wattnotions/PrettySmallRobot/README.md

[Watch the video here](https://www.youtube.com/watch?v=d6PTFtglKmE&feature=youtu.be)
