wattnotions/PrettySmallRobot/Kicad/adafruit_products_QT_Py_rev_C_sch.png

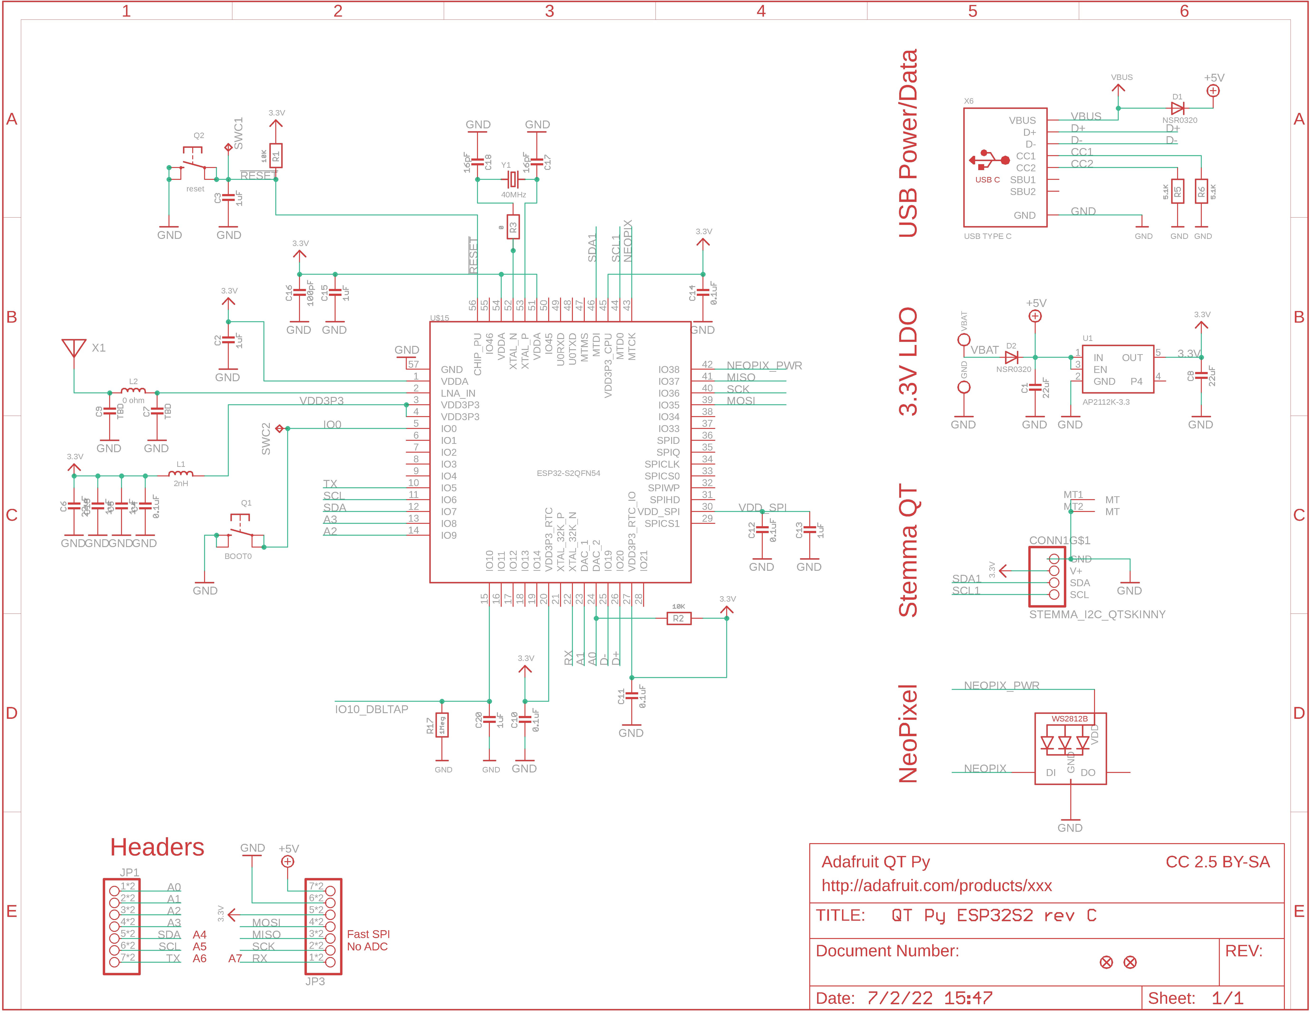
Kicad/adafruit_products_QT_Py_rev_C_sch.png
