wattnotions/PrettySmallRobot/Kicad/pi_matching_calcs.PNG

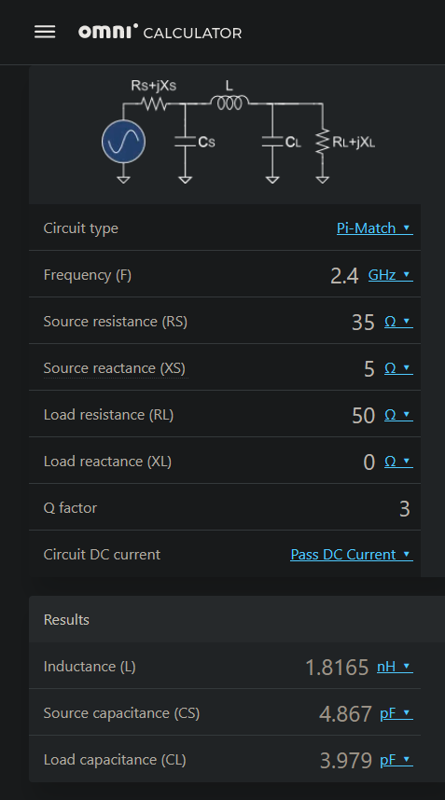
Kicad/pi_matching_calcs.PNG
