wattnotions/PrettySmallRobot/Kicad/wifi_car.PNG

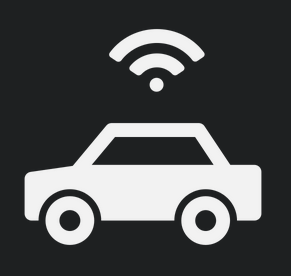
Kicad/wifi_car.PNG
