wattnotions/PrettySmallRobot/Kicad/PrettySmallRobot.step

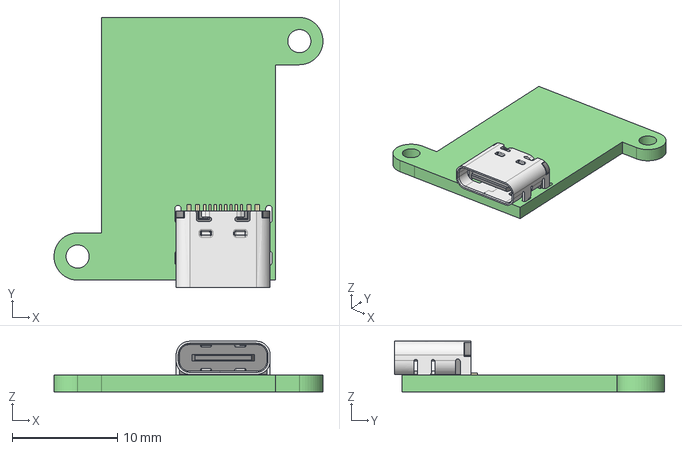
[picture p4: CAD file, 2023-01-18]
Kicad/PrettySmallRobot.step
25.6 x 25.7 x 4.82 mm
PrettySmallRobot PCB
