wattnotions/PrettySmallRobot/Step_files/Motor_Wheel.stl

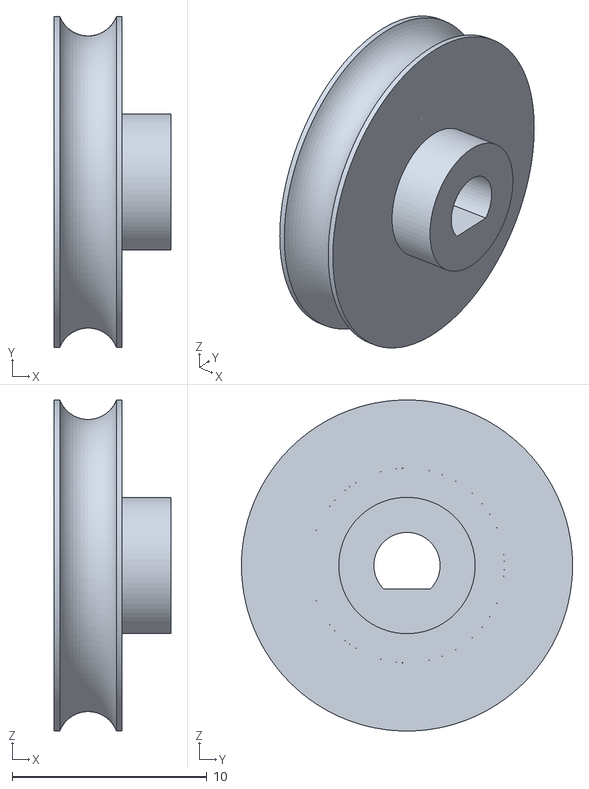
[picture p5: CAD file, 2023-03-26]
Step_files/Motor_Wheel.stl
6.00 x 17.0 x 17.0
