wattnotions/PrettySmallRobot/Step_files/Bearing_Wheel.stl

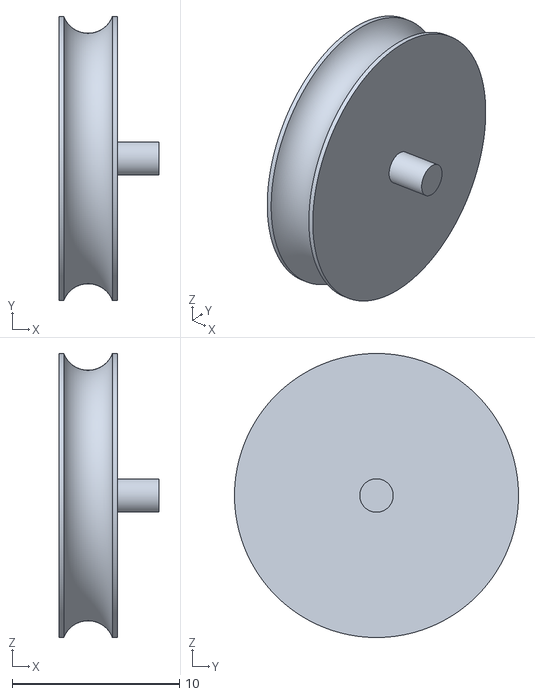
[picture p6: CAD file, 2023-03-26]
Step_files/Bearing_Wheel.stl
6.00 x 17.0 x 17.0
