wattnotions/PrettySmallRobot/Step_files/Chassis.stl

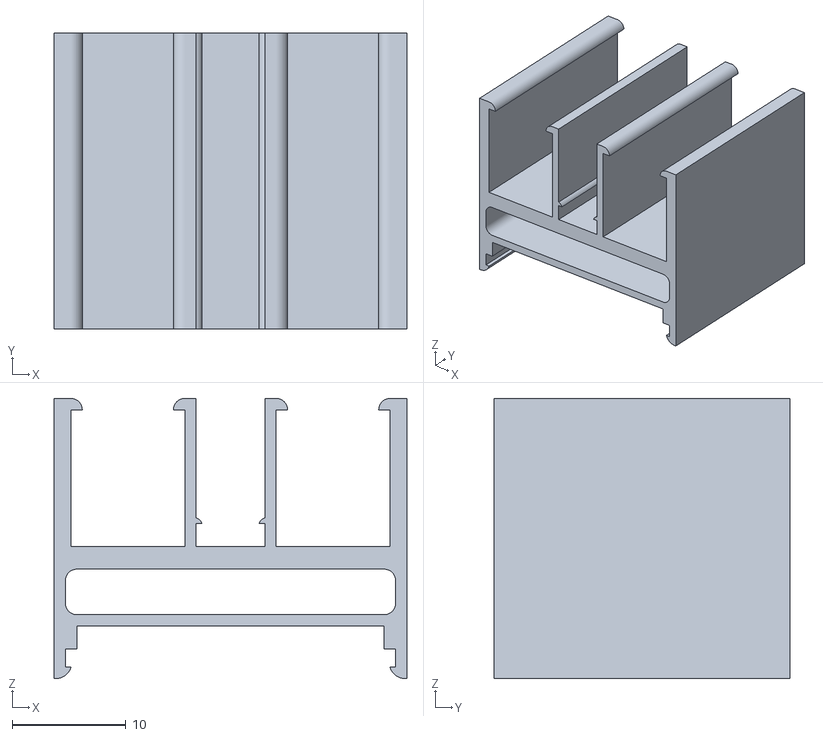
[picture p7: CAD file, 2023-01-28]
Step_files/Chassis.stl
31.0 x 26.0 x 24.6
