wattnotions/PrettySmallRobot/Kicad/PrettySmallRobot.pdf

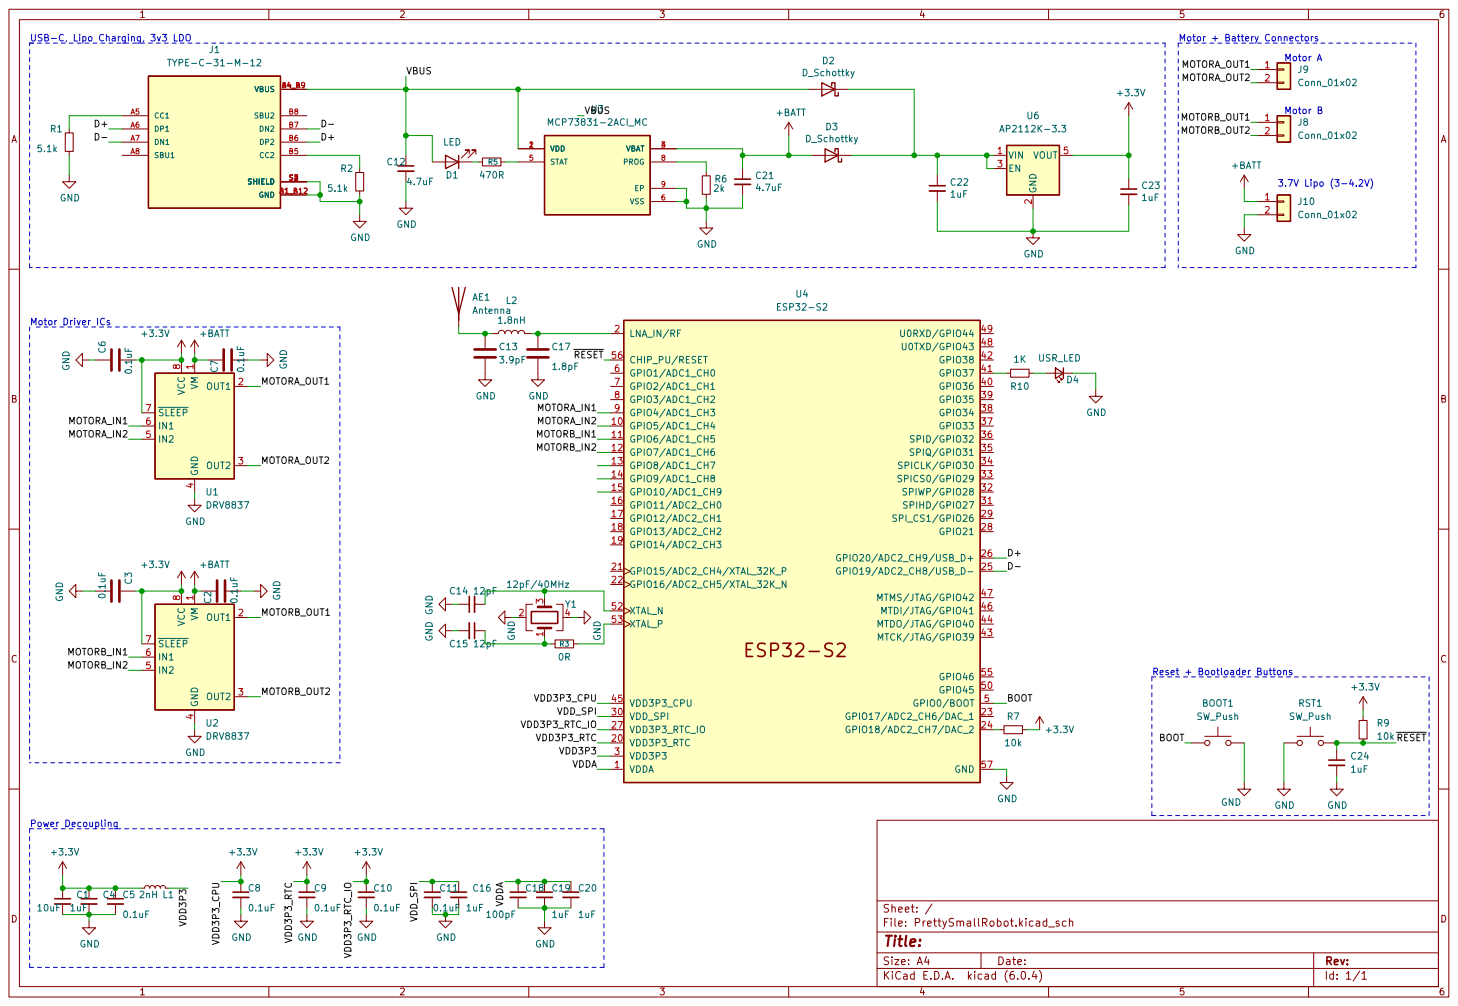
[picture p8: page 1]

2 EN 3 VOUT 5 U6 AP2112K-3.3 GND GND

File: PrettySmallRobot.kicad_sch Sheet: / GND GND
