wattnotions/PrettySmallRobot/Kicad/SCH.pdf

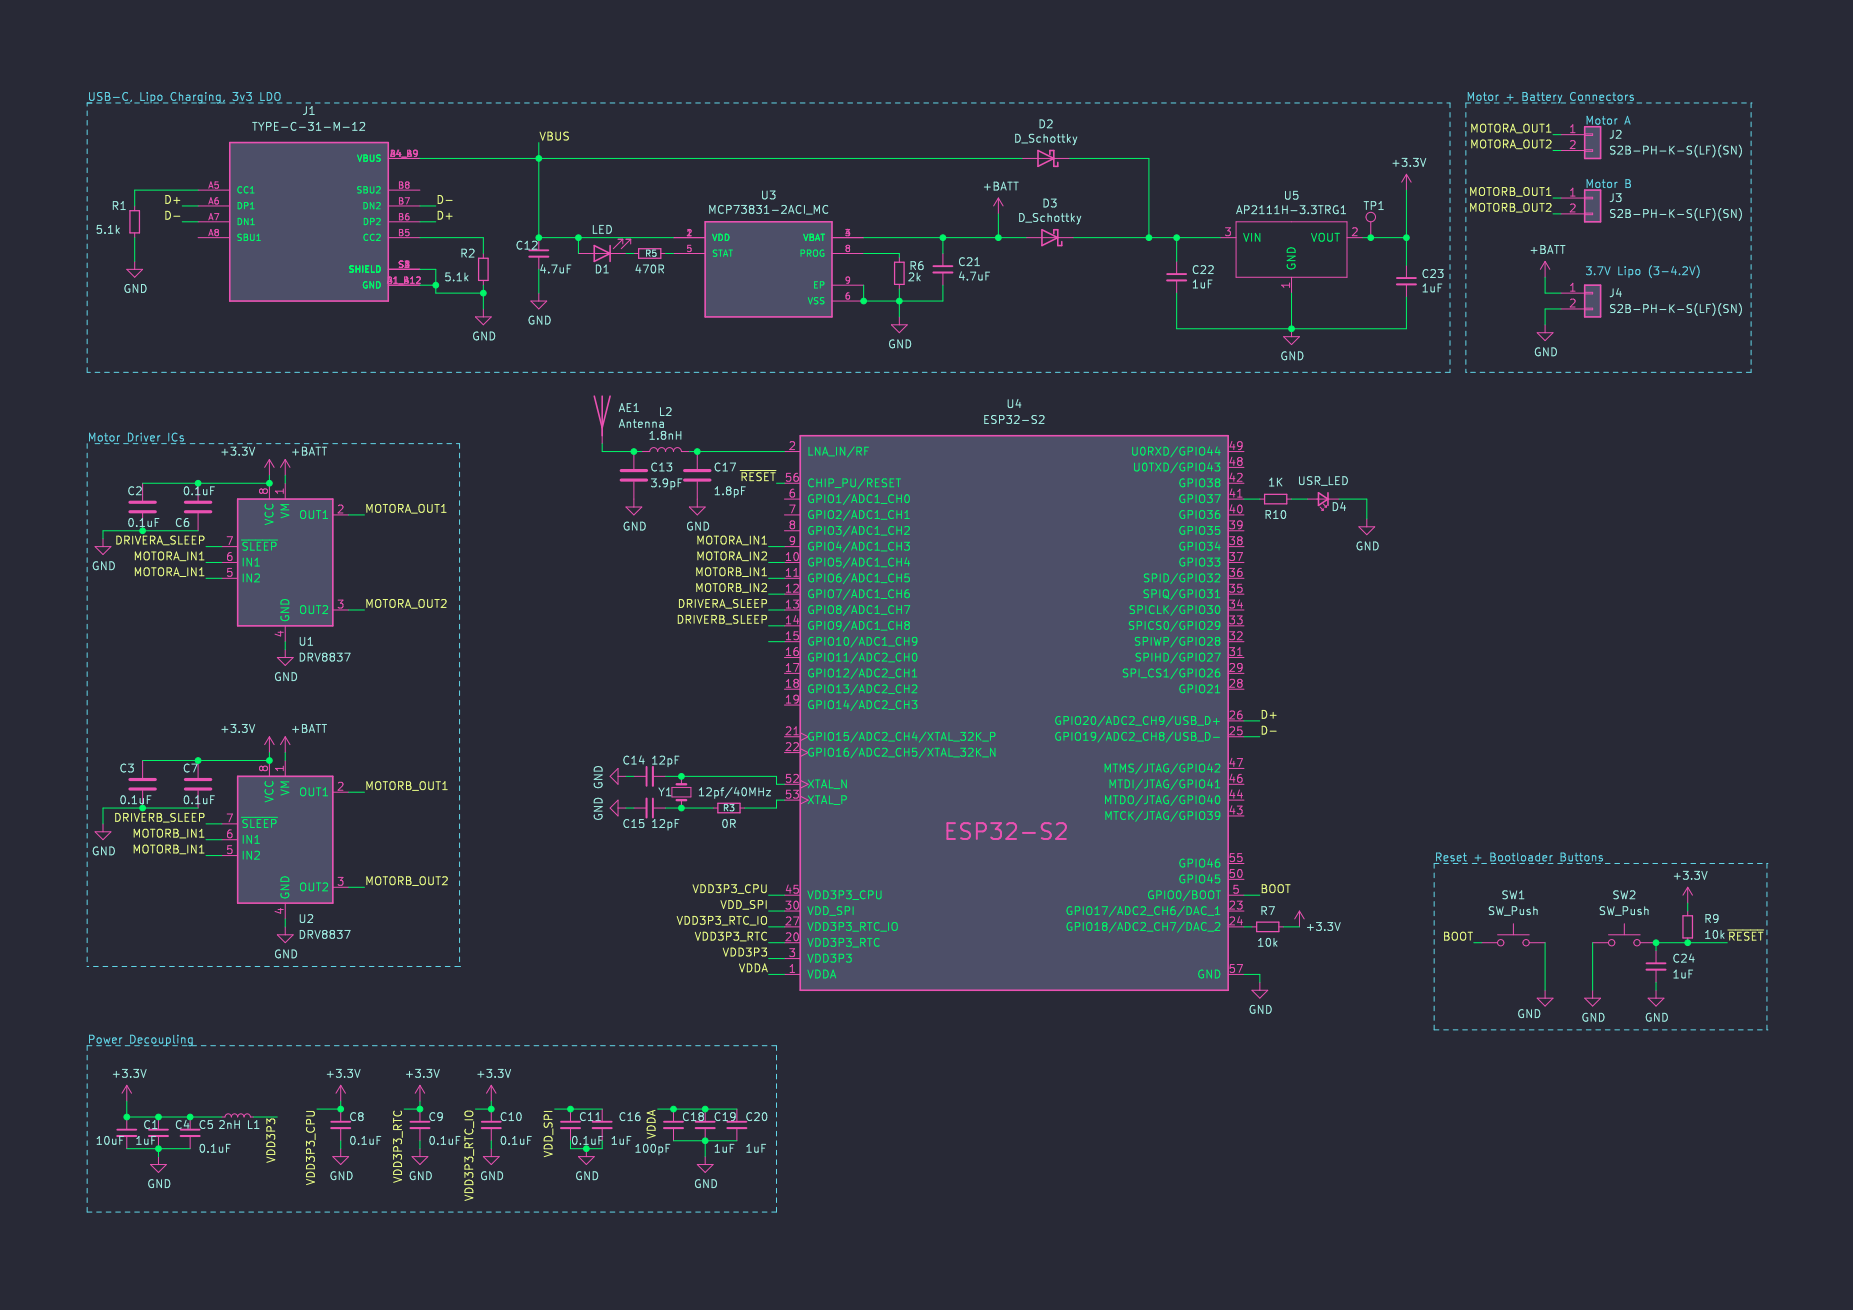
[picture p9: page 1]
