wattnotions/PrettySmallRobot/Kicad/PrettySmallRobot.kicad_pcb

## KiCad design Kicad/PrettySmallRobot.kicad_pcb (2023-03-03)

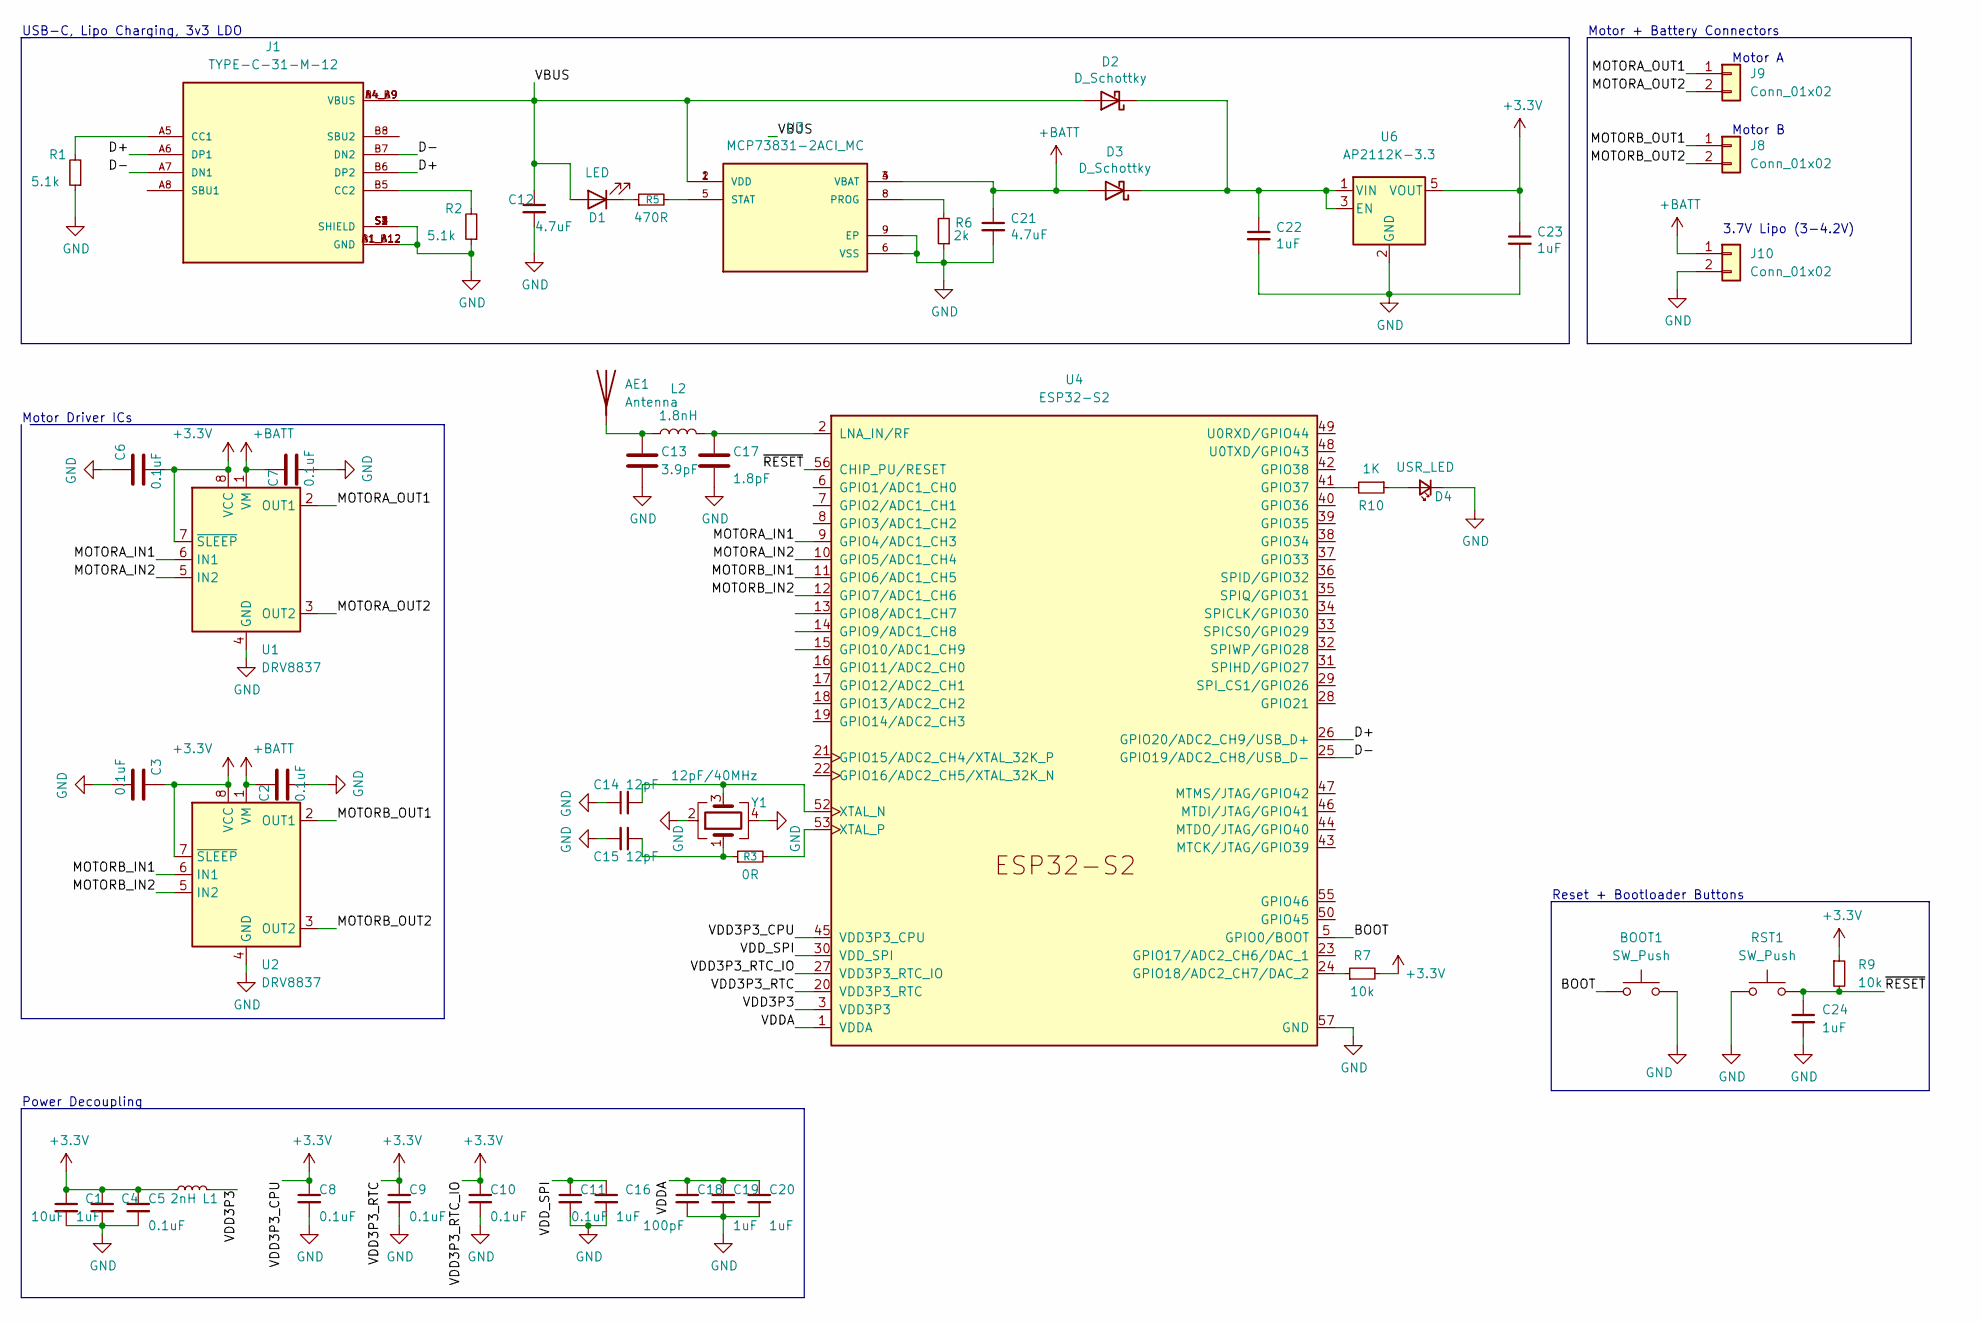
[picture p10: schematic PrettySmallRobot.kicad_sch]

Parts:
AE1: Antenna; C_1206_3216Metric; LCSC C293767
BOOT1: SW_Push; SW_SPST_B3U-1000P; LCSC C231329
C1: 10uF; C_0603_1608Metric
C2, C3, C5, C6, C7, C8, C9, C10, C11: 0.1uF; C_0402_1005Metric
C4, C16, C19, C20, C22, C23, C24: 1uF; C_0402_1005Metric
C12, C21: 4.7uF; C_0402_1005Metric
C13: 3.9pF; C_0402_1005Metric; LCSC C313081
C14, C15: 12pF; C_0402_1005Metric; LCSC C1547
C17: 1.8pF; C_0402_1005Metric; LCSC C140677
C18: 100pF; C_0402_1005Metric
D1: LED; LED_0402_1005Metric
D2, D3: D_Schottky; D_SOD-323; LCSC C146335
D4: USR_LED; LED_0402_1005Metric
J1: TYPE-C-31-M-12; HRO_TYPE-C-31-M-12; PARTREV 2020.12.08; LCSC C165948
J8, J9, J10: Conn_01x02; JST_PH_S2B-PH-K_1x02_P2.00mm_Horizontal
L1: 2nH; L_0402_1005Metric
L2: 1.8nH; L_0402_1005Metric; LCSC C87530
R1, R2: 5.1k; R_0402_1005Metric
R3: 0R; R_0402_1005Metric
R5: 470R; R_0402_1005Metric
R6: 2k; R_0402_1005Metric
R7, R9: 10k; R_0402_1005Metric
R10: 1K; R_0402_1005Metric
RST1: SW_Push; SW_SPST_B3U-1000P; LCSC TSA363G25-250B
U1, U2: DRV8837; WSON-8-1EP_2x2mm_P0.5mm_EP0.9x1.6mm; LCSC C191000
U3: MCP73831-2ACI_MC; SON50P200X300X100-9N; PARTREV G; LCSC C150772
U4: ESP32-S2; QFN-56-1EP_7x7mm_P0.4mm_EP5.6x5.6mm; LCSC C529594
U6: AP2112K-3.3; SOT-23-5; LCSC C3021085
Y1: 12pF/40MHz; Crystal_SMD_3225-4Pin_3.2x2.5mm; LCSC C252255

Connections:
+3V3: C1.1, C3.1, C4.1, C5.1, C6.1, C8.1, C9.1, C10.1, C23.1, L1.1, R7.2, R9.1, U1.7 (~SLEEP), U1.8 (VCC), U2.7 (~SLEEP), U2.8 (VCC), U4.20 (VDD3P3_RTC), U4.27 (VDD3P3_RTC_IO), U4.45 (VDD3P3_CPU), U6.5 (VOUT)
+BATT: C2.1, C7.1, C21.1, D3.2 (A), J10.1, U1.1 (VM), U2.1 (VM), U3.3 (VBAT), U3.4 (VBAT)
/BOOT: BOOT1.1, U4.5 (GPIO0/BOOT)
/D+: J1.A6 (DP1), J1.B6 (DP2), U4.26 (GPIO20/ADC2_CH9/USB_D+)
/D-: J1.A7 (DN1), J1.B7 (DN2), U4.25 (GPIO19/ADC2_CH8/USB_D-)
/MOTORA_IN1: U1.6 (IN1), U4.9 (GPIO4/ADC1_CH3)
/MOTORA_IN2: U1.5 (IN2), U4.10 (GPIO5/ADC1_CH4)
/MOTORA_OUT1: J9.1, U1.2 (OUT1)
/MOTORA_OUT2: J9.2, U1.3 (OUT2)
/MOTORB_IN1: U2.6 (IN1), U4.11 (GPIO6/ADC1_CH5)
/MOTORB_IN2: U2.5 (IN2), U4.12 (GPIO7/ADC1_CH6)
/MOTORB_OUT1: J8.1, U2.2 (OUT1)
/MOTORB_OUT2: J8.2, U2.3 (OUT2)
/VBUS: C12.1, D1.2 (A), D2.2 (A), J1.A4_B9 (VBUS), J1.B4_A9 (VBUS), U3.1 (VDD), U3.2 (VDD)
/VDD3P3: L1.2, U4.3 (VDD3P3), U4.4 (VDD3P3)
/VDDA: C18.1, C19.1, C20.1, U4.1 (VDDA), U4.51 (VDDA), U4.54 (VDDA)
/VDD_SPI: C11.1, C16.1, U4.30 (VDD_SPI)
/~RESET: C24.1, R9.2, RST1.2, U4.56 (CHIP_PU/RESET)
GND: BOOT1.2, C1.2, C2.2, C3.2, C4.2, C5.2, C6.2, C7.2, C8.2, C9.2, C10.2, C11.2, C12.2, C13.2, C14.1, C15.2, C16.2, C17.2, C18.2, C19.2, C20.2, C21.2, C22.2, C23.2, C24.2, D4.1 (K), J1.A1_B12 (GND), J1.B1_A12 (GND), J1.S1 (SHIELD), J1.S2 (SHIELD), J1.S3 (SHIELD), J1.S4 (SHIELD), J10.2, R1.1, R2.1, R6.1, RST1.1, U1.4 (GND), U1.9 (GND), U2.4 (GND), U2.9 (GND), U3.6 (VSS), U3.9 (EP), U4.57 (GND), U6.2 (GND), Y1.2, Y1.4
unnamed: AE1.1 (A), C13.1, L2.1
unnamed: C14.2, U4.52 (XTAL_N), Y1.3
unnamed: C15.1, R3.1, Y1.1
unnamed: C17.1, L2.2, U4.2 (LNA_IN/RF)
unnamed: C22.1, D2.1 (K), D3.1 (K), U6.1 (VIN), U6.3 (EN)
unnamed: D1.1 (K), R5.1
unnamed: D4.2 (A), R10.1
unnamed: J1.A5 (CC1), R1.2
unnamed: J1.B5 (CC2), R2.2
unnamed: R3.2, U4.53 (XTAL_P)
unnamed: R5.2, U3.5 (STAT)
unnamed: R6.2, U3.8 (PROG)
unnamed: R7.1, U4.24 (GPIO18/ADC2_CH7/DAC_2)
unnamed: R10.2, U4.41 (GPIO37)

Notes on the sheet:
Reset + Bootloader Buttons
USB-C, Lipo Charging, 3v3 LDO
Motor A
Power Decoupling
Motor B
3.7V Lipo (3-4.2V)
Motor Driver ICs
Motor + Battery Connectors

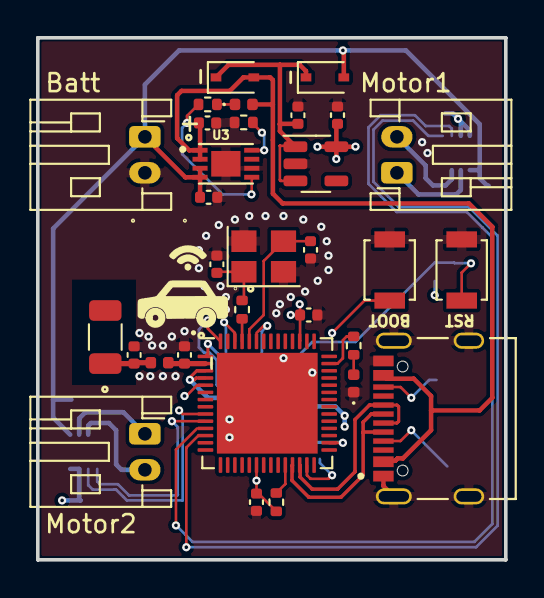
[picture p11: board PrettySmallRobot.kicad_pcb from above]

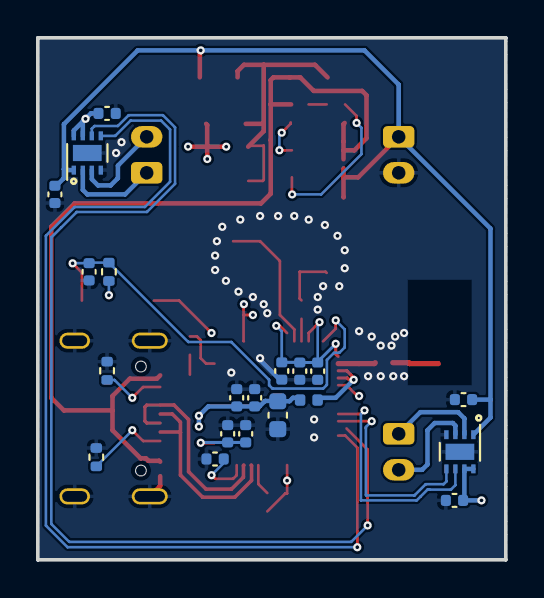
[picture p12: board PrettySmallRobot.kicad_pcb from below]

Board: 4 copper layers, 26.0 x 29.0 mm, 51 parts (20 on the bottom side), 33 nets.
