wattnotions/PrettySmallRobot/(threads)

Thread 1 (2023-05-31):

Motor type?

spezifisch, 2023-05-31:
Hello, what a nice project!

You write in [your post](https://www.wattnotions.com/pretty-small-robot-first-working-prototype/) that you consider a lower ratio gearbox for the N20 motors.
Which gearbox are you currently using? And are you using the 6V version of this motor like [here](https://www.adafruit.com/product/4640) (but without encoder)?

Regards,
spezifisch

Thread 2 (2023-07-14):

Production (JLCPCB)

aguileraGit, 2023-07-14:
Anything special for production? Specifically around the impedance on the antenna trace?

Does the KiCad file include the design rules for JLC PCB?
