wattnotions/PrettySmallRobot/(commit log)

2023-01-12 1ST COMMIT
    [Body1.stl, Body1_v2.stl, Body1_v3.stl, CHASSIS_V2.stl, PrettySmallRobot.kicad_pcb, PrettySmallRobot.kicad_sch, Wheel.stl, bearing_wheel.stl]
2023-01-12 added antenna match circuit
    [PrettySmallRobot.kicad_sch]
2023-01-12 schematic progressed
    [PrettySmallRobot.kicad_sch]
2023-01-12 progressed schematic
    [PrettySmallRobot.kicad_sch]
2023-01-14 usb c nets done, started on esp32 nets
    [PrettySmallRobot.kicad_sch]
2023-01-14 progressed esp32 schem nets
    [PrettySmallRobot.kicad_sch]
2023-01-14 cleaned up schematic - added boxes around sections etc
    [PrettySmallRobot.kicad_sch]
2023-01-14 worked on motor driver signals
    [PrettySmallRobot.kicad_sch]
2023-01-14 added testpoint on 3v3
    [PrettySmallRobot.kicad_sch]
2023-01-15 removed pullups on driver enable signals
    [PrettySmallRobot.kicad_sch]
2023-01-15 added pi matching network vals + lcsc numbers
    [PrettySmallRobot.kicad_sch]
2023-01-15 matched 90% of parts with footprints
    [PrettySmallRobot.kicad_sch]
2023-01-15 preliminary floorplanning done
    [PrettySmallRobot.kicad_pcb, PrettySmallRobot.kicad_sch]
2023-01-17 replaced 3.3v ldo with ap2112k
    [PrettySmallRobot.kicad_pcb, PrettySmallRobot.kicad_sch]
2023-01-17 replaced jst connectors with smd solder pads
    [PrettySmallRobot.kicad_pcb, PrettySmallRobot.kicad_sch]
2023-01-17 routing bout 70% done
    [PrettySmallRobot-Edge_Cuts.dxf, PrettySmallRobot.kicad_pcb, outline.dxf]
2023-01-18 routed motor driver sigs
    [PrettySmallRobot.kicad_pcb, PrettySmallRobot.kicad_sch]
2023-01-18 fixed drc issues
    [PrettySmallRobot.kicad_pcb, PrettySmallRobot.kicad_sch, PrettySmallRobot.step]
2023-01-18 àdded car graphic
    [PrettySmallRobot.kicad_pcb]
2023-01-27 ripped up all routing to start again to fit the new cad
    [22222.stl, 55555.stl, 666.stl, BRACKETV2.stl, Body1.stl, Body1_v2.stl, Body1_v3.stl, CHASSIS_V2.stl]
2023-01-28 resized board to 29x27mm
    [PrettySmallRobot.kicad_pcb, Resistance_Calculations.kicad_sch]
2023-01-28 resized board again to 29x26mm
    [PrettySmallRobot.kicad_pcb]
2023-01-28 re added jst connectors, removed mount holes
    [PrettySmallRobot.kicad_pcb, PrettySmallRobot.kicad_sch, almostdone.stl]
2023-01-28 added keeput area for clip sections
    [PrettySmallRobot.kicad_pcb]
2023-01-28 floorplanning 50% done
    [PrettySmallRobot.kicad_pcb]
2023-01-28 routing started
    [PrettySmallRobot.kicad_pcb]
2023-01-28 swapped motor a and b connectors
    [PrettySmallRobot.kicad_pcb, PrettySmallRobot.kicad_sch]
2023-01-28 all nets routed, drc done
    [PrettySmallRobot.kicad_pcb]
2023-01-29 changed mcp 73831 to diff package in stock on jlcpcb
    [PrettySmallRobot-B_Cu.gbr, PrettySmallRobot-B_Mask.gbr, PrettySmallRobot-B_Paste.gbr, PrettySmallRobot-B_Silkscreen.gbr, PrettySmallRobot-Edge_Cuts.gbr, PrettySmallRobot-F_Cu.gbr, PrettySmallRobot-F_Mask.gbr, PrettySmallRobot-F_Paste.gbr]
2023-03-03 update to latest
    [PrettySmallRobot-B_Cu.gbr, PrettySmallRobot-B_Mask.gbr, PrettySmallRobot-B_Paste.gbr, PrettySmallRobot-B_Silkscreen.gbr, PrettySmallRobot-Edge_Cuts.gbr, PrettySmallRobot-F_Cu.gbr, PrettySmallRobot-F_Mask.gbr, PrettySmallRobot-F_Paste.gbr]
2023-03-03 added some motor control code
2023-03-05 added mqtt remote control stuff
    [PrettySmallRobot.kicad_sch]
2023-03-12 made server side robot wheel mqtt script
2023-03-12 firimware to accept mqtt commads from wheel, working
2023-03-14 changed adc cut of val to 100
2023-03-26 re-arraned folder structure
    [22222.stl, 55555.stl, 666.stl, BRACKETV2.stl, Bearing_Wheel.stl, Chassis.stl, Motor_Wheel.stl, NEWONEV2SHINY.stl]
